edlang90/FlashBack-Diversity/Hardware/README.md

# Hardware

This section contains all the hardware related documents. 

The schematic includes the connections for an on-board OLED display, but this was not included in the final design. The components shown inside this block are still reflected in the BOM, but are not needed for the PCB.
