edlang90/FlashBack-Diversity/Hardware/Pictures/PCB back.png

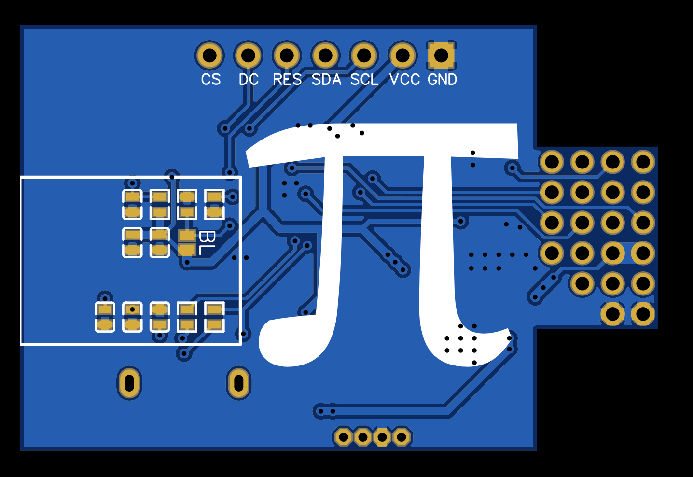
Hardware/Pictures/PCB back.png
