edlang90/FlashBack-Diversity/Hardware/Pictures/Values back.png

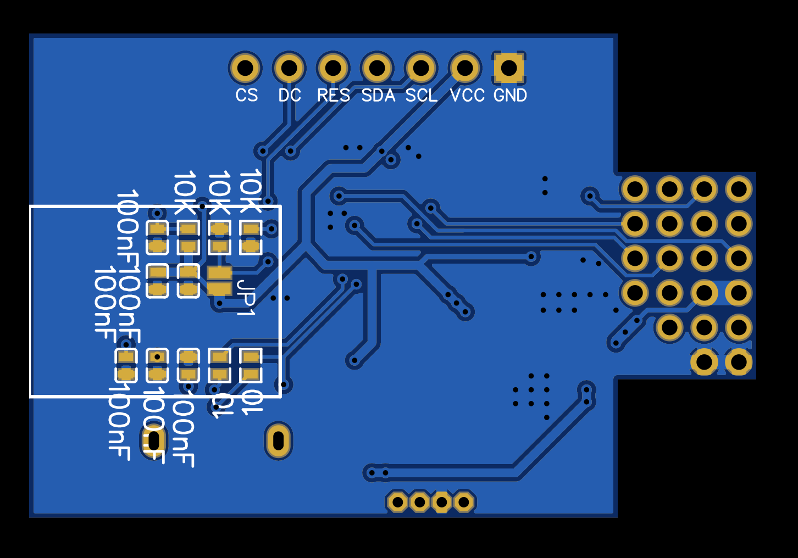
Hardware/Pictures/Values back.png
