edlang90/FlashBack-Diversity/Hardware/Pictures/Values front.png

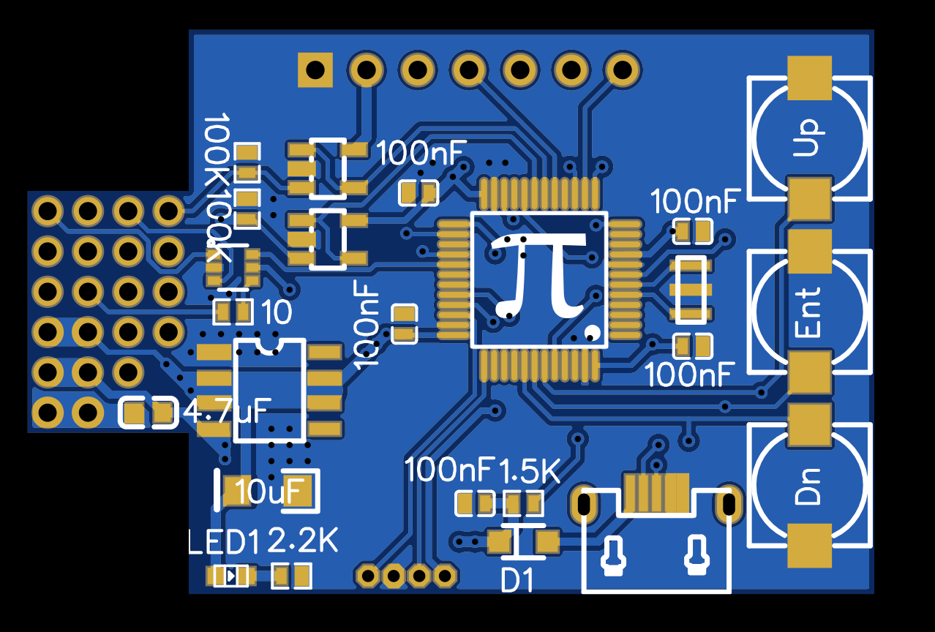
Hardware/Pictures/Values front.png
