edlang90/FlashBack-Diversity/Hardware/Flashback Schematic.pdf

128 x 64

## Active Area 0.96

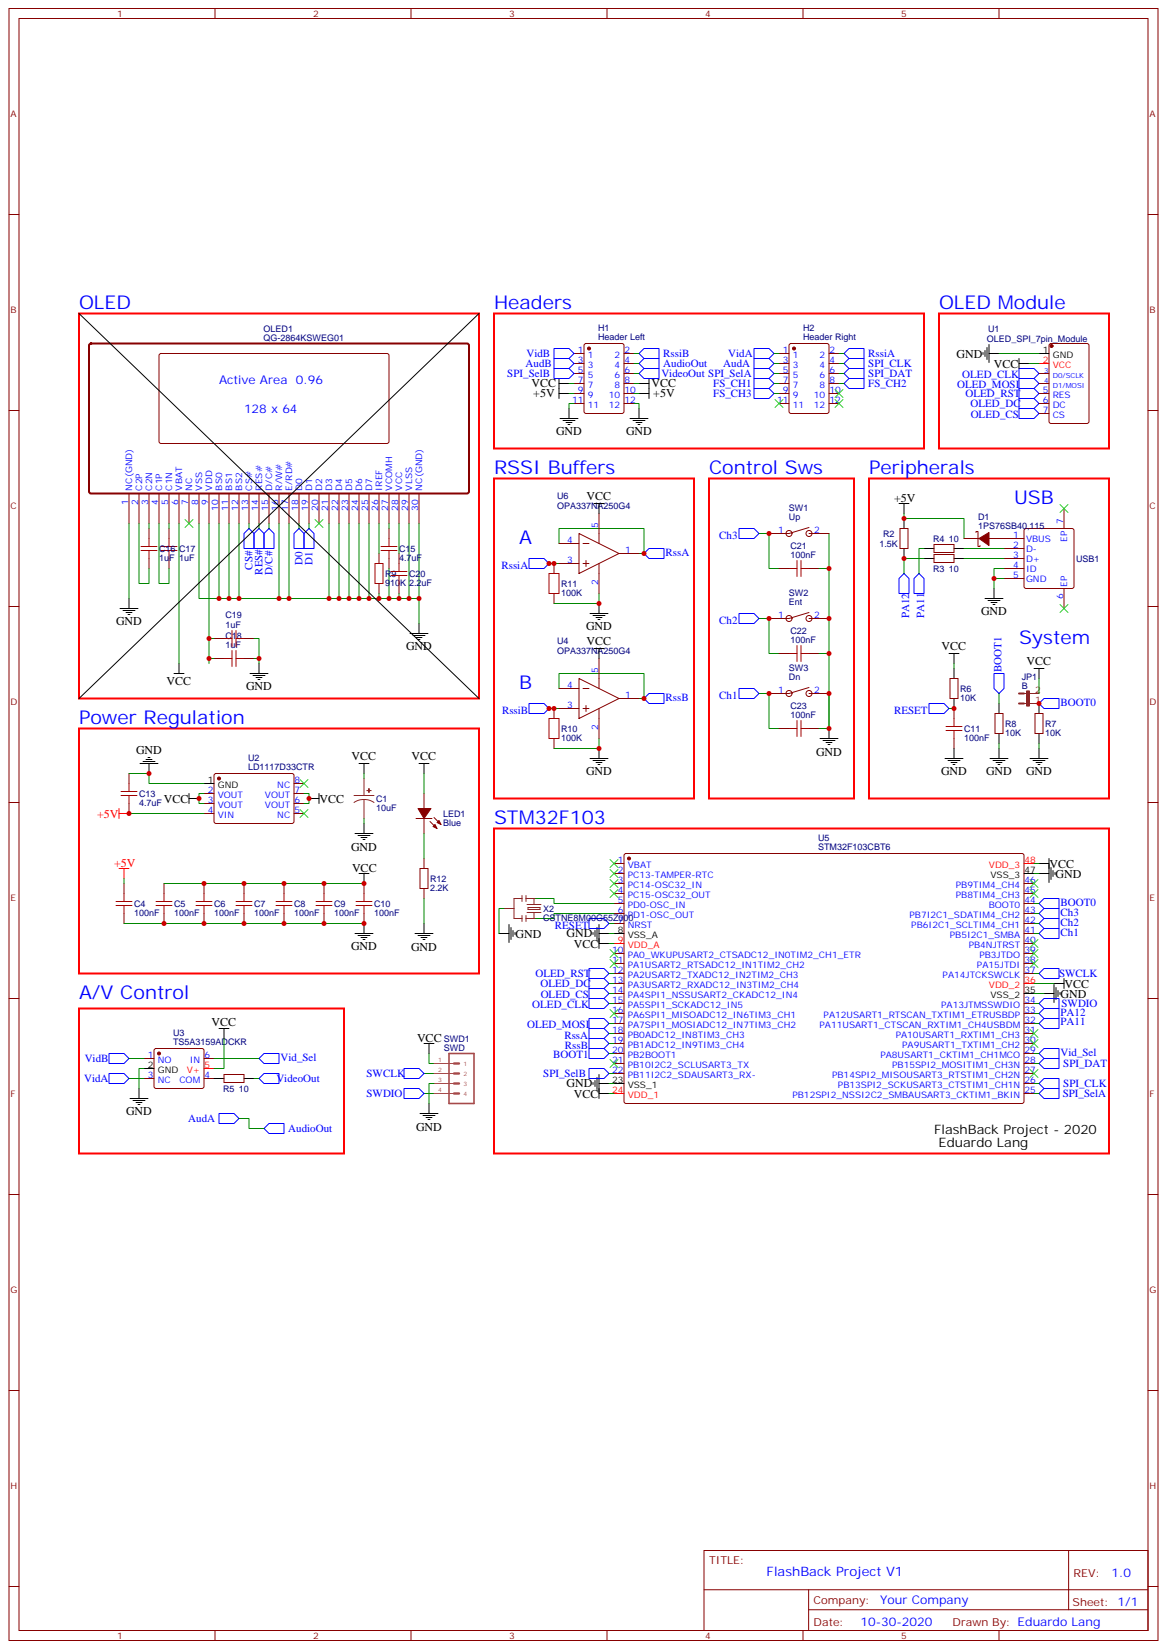
[picture p5: page 1]

Drawn By: Eduardo Lang
