edlang90/FlashBack-Diversity/(commit log)

2021-02-04 Gerber PCB Fabrication files
2021-02-04 BOM file
    [Flashback BOM.csv]
2021-02-04 Update CSV
    [Flashback BOM.csv]
